malkadi/FGPU/benchmark/HLS/README.md

This folder contains implementations of some selected appplications using Vivado HLS (v2016.2).

+ The folders <application>_HLS_project are the HLS projects 
+ The folder <application>_vivado contains:
  + The device utilization and timing reports when implementing the HLS cores (on ZC706)
  + A script to generate the corresponding SDK projects to measure the execution time/power consumption of each core
