malkadi/FGPU/benchmark/HLS/fir_vivado/fir_vivado.sdk/results.txt

solution1: 7174
solution2: 5637
solution3: 231
