malkadi/FGPU/(threads)

Thread 2 (2022-10-18):

PYNQ-Z2

Bahadiirr, 2022-10-18:
can i do this project on PYNQ Z2 board?

omerguzelelectronicguy, 2022-10-27:
I don't know the versions of ZYNQ devices however it is written like that in [this repo](https://github.com/CEatBTU/FGPU):

> Easily portable to ZYNQ devices. For Ultrascale+ architecture, check branch ultrascale.

That repo stated below that they are continuing the development of this project. If the above quotation doesn't answer enough, you may try to find an answer on that page.

> FGPU is currently being developed and maintained by the [Chair of Computer Engineering at the Brandenburg University of Technology Cottbus-Senftenberg](https://www.b-tu.de/en/computer-engineering-group), in Germany. It was [originally developed](https://github.com/malkadi/FGPU) by Muhammed Al Kadi from the [Ruhr University Bochum](https://www.ei.ruhr-uni-bochum.de/fakultaet/), in Germany.
