malkadi/FGPU/benchmark/LUdecomposition/src/code.c

unsigned int ludecomposition[] = {
	0x11ffd3ff,
	0xdc002fe9,
	0xdc002bea,
	0xdc0027eb,
	0xdc0023ec,
	0xdc001fed,
	0xdc001bee,
	0xdc0017ef,
	0xdc0013f0,
	0xdc000ff1,
	0xdc000bf2,
	0xdc0007f3,
	0x10000403,
	0x34000c41,
	0x1900000c,
	0x1d00004c,
	0x30003021,
	0x29005c64,
	0x3103fc85,
	0x11fffca4,
	0x1103f406,
	0xb60010c9,
	0x11000006,
	0x19fffc64,
	0x1d01fc04,
	0x30001068,
	0x3000104a,
	0x29005c47,
	0x3103fce7,
	0x63001409,
	0x11fffce9,
	0x1103f80b,
	0xb6002d2b,
	0x10001809,
	0x6301b00b,
	0x19fffc6b,
	0x1dfffc2b,
	0x30002c69,
	0x1900040d,
	0x1dfe002d,
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
};
unsigned *code = ludecomposition;
