malkadi/FGPU/benchmark/matrix_multiply/src/code.c

unsigned int matrix_multiply[] = {
	0x11fffbff,
	0xdc0007e9,
	0xdc0003ea,
	0x19fffc63,
	0x1dfffc23,
	0x30000c24,
	0x11fffc85,
	0x19fff866,
	0x1dfdfc26,
	0xb60014c6,
	0x30000c45,
	0x63001406,
	0x11fffca3,
	0x19fffc66,
	0x1dfdfc26,
	0xb6001863,
	0x63006403,
	0x34000443,
	0x19000006,
	0x1d000046,
	0x34001863,
	0x19000008,
	0x1dff0028,
	0x10000407,
	0x48000d07,
	0x19000006,
	0x1dfe0026,
	0x34001889,
	0x10000403,
	0x480024e3,
	0xb60014c7,
	0xb60010c9,
	0x32001d27,
	0x40001d03,
	0x620364c4,
	0x63036007,
	0x10000803,
	0x620358c5,
	0x63000404,
	0x6202dc00,
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
};
unsigned *code = matrix_multiply;
