malkadi/FGPU/benchmark/nbody/src/kernel_descriptor.cpp

#include "kernel_descriptor.hpp"

#define PRINT_ERRORS  1
extern unsigned int *code; // binary storde in code.c as an array

template<typename T>
kernel<T>::kernel(unsigned max_size)
{
  position = new T[4*max_size];
  new_position_arm = new T[4*max_size];
  new_position_fgpu = new T[4*max_size];
  velocity = new T[4*max_size];
  new_velocity_arm = new T[4*max_size];
  new_velocity_fgpu = new T[4*max_size];
  deltaTime = 0.005;
  epsSqr = 500;
}
template<typename T>
kernel<T>::~kernel() 
{
  delete[] position;
  delete[] new_position_arm;
  delete[] new_position_fgpu;
  delete[] velocity;
  delete[] new_velocity_arm;
  delete[] new_velocity_fgpu;
}
template<typename T>
void kernel<T>::download_code()
{
  volatile unsigned *cram_ptr = (unsigned *)(FGPU_BASEADDR+ 0x4000);
  unsigned int size = NBODY_LEN;
  if(typeid(T) == typeid(float))
    start_addr = NBODY_ITER_POS;
  else
    assert(0 && "unsupported type");
  unsigned i = 0;
  for(; i < size; i++){
    cram_ptr[i] = code[i];
  }
}
template<typename T>
void kernel<T>::download_descriptor()
{
  int i;
  volatile unsigned* lram_ptr = (unsigned*)FGPU_BASEADDR;
  for(i = 0; i < 32; i++)
    lram_ptr[i] = 0;
  lram_ptr[0] = ((nWF_WG-1) << 28) | (0 << 14) | (start_addr);
  lram_ptr[1] = size0;
  lram_ptr[2] = size1;
  lram_ptr[3] = size2;
  lram_ptr[4] = offset0;
  lram_ptr[5] = offset1;
  lram_ptr[6] = offset2;
  lram_ptr[7] = ((nDim-1) << 30) | (wg_size2 << 20) | (wg_size1 << 10) | (wg_size0);
  lram_ptr[8] = n_wg0-1;
  lram_ptr[9] = n_wg1-1;
  lram_ptr[10] = n_wg2-1;
  lram_ptr[11] = (nParams << 28) | wg_size;
  lram_ptr[16] = (unsigned) position;
  lram_ptr[17] = (unsigned) velocity;
  lram_ptr[18] = (unsigned) toRep(deltaTime);
  lram_ptr[19] = (unsigned) toRep(epsSqr);
  lram_ptr[20] = (unsigned) new_position_fgpu;
  lram_ptr[21] = (unsigned) new_velocity_fgpu;

}
template<typename T>
void kernel<T>::compute_descriptor()
{
  assert(wg_size0 > 0 && wg_size0 <= 512);
  assert(size0 % wg_size0 == 0);
  size = size0;
  wg_size = wg_size0;
  n_wg0 = size0 / wg_size0;
  if(nDim > 1)
  {
    assert(wg_size1 > 0 && wg_size1 <= 512);
    assert(size1 % wg_size1 == 0);
    size = size0 * size1;
    wg_size = wg_size0 * wg_size1;
    n_wg1 = size1 / wg_size1;
  }
  else
  {
    wg_size1 = n_wg1 = size1 = 0;
  }
  if(nDim > 2)
  {
    assert(wg_size2 > 0 && wg_size2 <= 512);
    assert(size2 % wg_size2 == 0);
    size = size0 * size1 * size2;
    wg_size = wg_size0 * wg_size1 * wg_size2;
    n_wg2 = size2 / wg_size2;
  }
  else
  {
    wg_size2 = n_wg2 = size2 = 0;
  }
  assert(wg_size <= 512);
  nWF_WG = wg_size / 64;
  if(wg_size % 64 != 0)
    nWF_WG++;
}
template<typename T>
void kernel<T>::prepare_descriptor(unsigned int Size)
{
  wg_size0 = 64;
  problemSize = Size;
  offset0 = 0;
  nDim = 1;
  size0 = Size;
  dataSize = sizeof(T) * problemSize;

  if(size0 < 64)
    wg_size0 = size0;

  compute_descriptor();

  offset0 = offset1 = offset2 = 0;
  nParams = 6; // number of parameters
}
template<typename T>
unsigned kernel<T>::get_problemSize() 
{
  return problemSize;
}
template<typename T>
void kernel<T>::initialize_memory()
{
  unsigned i;
  T *pos_ptr = (T*) position;
  T *vel_ptr = (T*) velocity;
  for(i = 0; i < 4*problemSize; i++) 
  {
    pos_ptr[i] = (T)i;
    vel_ptr[i] = (T)i;
  }
  Xil_DCacheFlush(); // flush data to global memory
}
void Nbody_iter(unsigned problemSize, float *initPos, float *newPos, float *initVel, float *newVel, float softeningFactor, float deltaTime) 
{
  unsigned body, i;
  float x1, y1, z1, x2, y2, z2, m2;
  float xdiff, ydiff, zdiff, distSquared;
  float accx, accy, accz;
  float invDist, invDistCube, s;
  float oldVelx, oldVely, oldVelz;
  for( body = 0; body < problemSize; body++) {
    /* printf("initPos[i].x = %f\n", initPos[4*body]); */
    x1 = initPos[body*4];
    y1 = initPos[body*4+1];
    z1 = initPos[body*4+2];
    accx = 0;
    accy = 0;
    accz = 0;
    for (i = 0; i < problemSize; i++) {
      x2 = initPos[i*4];
      y2 = initPos[i*4+1];
      z2 = initPos[i*4+2];
      m2 = initPos[i*4+3];
      xdiff = x2 - x1;
      ydiff = y2 - y1;
      zdiff = z2 - z1;
      distSquared = xdiff*xdiff + ydiff*ydiff + zdiff*zdiff;

      invDist = 1.0f / sqrtf(distSquared + softeningFactor);
      invDistCube = invDist * invDist * invDist;
      s = m2 * invDistCube;
      // accumulate effect of all particles
      accx += s * xdiff;
      /* printf("s = %f\n", s); */
      accy += s * ydiff;
      accz += s * zdiff;
    }

    oldVelx = initVel[body*4];
    oldVely = initVel[body*4+1];
    oldVelz = initVel[body*4+2];
    // updated position and velocity
    newPos[body*4] = x1 + oldVelx*deltaTime + accx*0.5f*deltaTime*deltaTime;
    newPos[body*4+1] = y1 + oldVely*deltaTime + accy*0.5f*deltaTime*deltaTime;
    newPos[body*4+2] = z1 + oldVelz*deltaTime + accz*0.5f*deltaTime*deltaTime;

    newVel[body*4] = oldVelx + accx*deltaTime;
    newVel[body*4+1] = oldVely + accy*deltaTime;
    newVel[body*4+2] = oldVelz + accz*deltaTime;
  }
}
template<typename T>
unsigned kernel<T>::compute_on_ARM(unsigned int n_runs)
{
  unsigned exec_time = 0;
  unsigned runs = 0;

  XTime tStart, tEnd;
  while(runs < n_runs)
  {
    initialize_memory();
    Xil_DCacheFlush();
    Xil_DCacheInvalidate();
    XTime_GetTime(&tStart);
    
    Nbody_iter(problemSize, position, new_position_arm, velocity, new_velocity_arm, epsSqr, deltaTime);

    // flush the results to the global memory 
    Xil_DCacheFlushRange((unsigned)new_position_arm, dataSize);
    Xil_DCacheFlushRange((unsigned)new_velocity_arm, dataSize);
    
    XTime_GetTime(&tEnd);
    exec_time += elapsed_time_us(tStart, tEnd);
    xil_printf(ANSI_COLOR_RED "." ANSI_COLOR_RESET);
    fflush(stdout);
    runs++;
    if(exec_time > 1000000*MAX_MES_TIME_S)
      break;
  }
  return exec_time/runs;
}
// void kernel<T>::check_FGPU_results()
// {
//   unsigned int i, nErrors = 0;
//   for (i = 0; i < problemSize; i++) {
//     for(unsigned k = 0; k < 3; k++) {
//       // float upper = new_position_arm[4*i+k]*1.001;
//       // float lower = new_position_arm[4*i+k]*0.999;
//       if(new_position_arm[4*i+k] != new_position_fgpu[4*i+k] ) {
//       // if(new_position_fgpu[4*i+k] < lower || new_position_fgpu[4*i+k] > upper) {
//         if(PRINT_ERRORS && nErrors < 10)
//           printf("newPosition[%d]=%f (must be %f)\n\r", 4*i+k, (float)new_position_fgpu[4*i+k], (float) new_position_arm[4*i+k]);
//         nErrors++;
//       }
//       // upper = new_velocity_arm[4*i+k]*1.01;
//       // lower = new_velocity_arm[4*i+k]*0.99;
//       if(new_velocity_arm[4*i+k] != new_velocity_fgpu[4*i+k] ) {
//       // if(new_velocity_fgpu[4*i+k] < lower || new_velocity_fgpu[4*i+k] > upper) {
//         if(PRINT_ERRORS && nErrors < 10)
//           printf("newVelocity[%d]=%f (must be %f)\n\r", 4*i+k, (float)new_velocity_fgpu[4*i+k], (float) new_velocity_arm[4*i+k]);
//           // printf("newVelocity[%d]=%x (must be %x)\n\r", 4*i+k, (unsigned)toRep(new_velocity_fgpu[4*i+k]), (unsigned) toRep(new_velocity_arm[4*i+k]));
//         nErrors++;
//       }
//     }
//   }
//   if(nErrors != 0)
//     xil_printf("Memory check failed (nErrors = %d)!\n\r", nErrors);
// }
template<typename T>
void kernel<T>::check_FGPU_results()
{
  unsigned int i, nErrors = 0;
  for (i = 0; i < problemSize; i++) {
    for(unsigned k = 0; k < 3; k++) {
      if(new_position_arm[4*i+k] != new_position_fgpu[4*i+k])
      {
        if(PRINT_ERRORS && nErrors < 10)
          printf("newPosition[%d]=%f (must be %f)\n\r", 4*i+k, (float)new_position_fgpu[4*i+k], (float) new_position_arm[4*i+k]);
        nErrors++;
      }
      if(new_velocity_arm[4*i+k] != new_velocity_fgpu[4*i+k])
      {
        if(PRINT_ERRORS && nErrors < 10)
          printf("newVelocity[%d]=%f (must be %f)\n\r", 4*i+k, (float)new_velocity_fgpu[4*i+k], (float) new_velocity_arm[4*i+k]);
        nErrors++;
      }
    }
  }
  if(nErrors != 0)
    xil_printf("Memory check failed (nErrors = %d)!\n\r", nErrors);
}
template<typename T>
unsigned kernel<T>::compute_on_FGPU(unsigned n_runs, bool check_results)
{
  unsigned runs = 0;
  XTime tStart, tEnd;
  unsigned exec_time = 0;

  while(runs < n_runs)
  {
    download_descriptor();
    REG_WRITE(INITIATE_REG_ADDR, 0xFFFF); // initiate FGPU when execution starts
    REG_WRITE(CLEAN_CACHE_REG_ADDR, 0xFFFF); // clean FGPU cache at end of execution
    
    XTime_GetTime(&tStart);
    REG_WRITE(START_REG_ADDR, 1);
    while(REG_READ(STATUS_REG_ADDR)==0);
    XTime_GetTime(&tEnd);
    exec_time += elapsed_time_us(tStart, tEnd);
    
    if(check_results)
      check_FGPU_results();

    xil_printf(ANSI_COLOR_GREEN "." ANSI_COLOR_RESET);
    fflush(stdout);
    runs++;

    if(exec_time > 1000000*MAX_MES_TIME_S)// do not execute all required runs if it took too long
      break;
  }
  return exec_time/runs;
}
template<typename T>
void kernel<T>::print_name()
{
  if( typeid(T) == typeid(float) )
    xil_printf("\n\r" ANSI_COLOR_YELLOW "Kernel is nbody float\n\r" ANSI_COLOR_RESET);
}

template class kernel<float>;
