malkadi/FGPU/benchmark/div/src/code.c

unsigned int div[] = {
	0x29007c23,
	0xb6000864,
	0x10000805,
	0x40001005,
	0x12001463,
	0x19000005,
	0x1d000045,
	0x40001005,
	0x21000463,
	0x29007824,
	0x31000484,
	0x32001063,
	0x19000004,
	0x1d000024,
	0xb6000866,
	0x40001804,
	0x32001484,
	0x10000805,
	0x40001805,
	0x12001463,
	0x29007425,
	0x310004a5,
	0x21000463,
	0x32001463,
	0x19000005,
	0x1d800005,
	0xb6000866,
	0x40001805,
	0x32001484,
	0x10000805,
	0x40001805,
	0x12001463,
	0x29007025,
	0x310004a5,
	0x21000463,
	0x32001463,
	0x19000005,
	0x1d400005,
	0xb6000866,
	0x40001805,
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
};
unsigned *code = div;
