malkadi/FGPU/benchmark/parallel_selection/src/code.c

unsigned int parallel_selection[] = {
	0xb2000444,
	0x11000405,
	0x11fffc06,
	0x10001403,
	0x400010c3,
	0xb2000824,
	0x10001407,
	0x400010c7,
	0x30000444,
	0xb20010c4,
	0x400010e3,
	0x32000444,
	0x19fffc66,
	0x1dfffc26,
	0x30001884,
	0x48001003,
	0x34000824,
	0x48001003,
	0x30001842,
	0x19000004,
	0x1dfe0024,
	0xb6000882,
	0x400008a3,
	0x30001821,
	0xb6000481,
	0x400004a3,
	0x10000c01,
	0x92000000,
	0xb2000444,
	0x11000405,
	0x11fffc06,
	0x10001403,
	0x400010c3,
	0xb2000824,
	0x10001407,
	0x400010c7,
	0x30000444,
	0xb20010c4,
	0x400010e3,
	0x32000444,
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
};
unsigned *code = parallel_selection;
