malkadi/FGPU/benchmark/max/src/code.c

unsigned int max[] = {
	0x32000443,
	0x19fffc64,
	0x1dfffc24,
	0x30001063,
	0x34000821,
	0xb7000421,
	0x11000402,
	0x48000c41,
	0x92000000,
	0x32000443,
	0x19fffc64,
	0x1dfffc24,
	0x30001063,
	0x34000821,
	0xb6000401,
	0x48000c01,
	0x92000000,
	0x30000443,
	0x11fffc04,
	0xb2000c84,
	0xb2000443,
	0xb2000825,
	0x400010a3,
	0x32000444,
	0x19fffc65,
	0x1dfffc25,
	0x30001484,
	0x11000405,
	0x480010a3,
	0x34000821,
	0x480004a3,
	0x10000c01,
	0x92000000,
	0x30000443,
	0x11fffc04,
	0xb2000c84,
	0xb2000443,
	0xb2000825,
	0x400010a3,
	0x32000444,
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
};
unsigned *code = max;
