malkadi/FGPU/benchmark/floydwarshall/src/code_hard_float.c

unsigned int floydwarshall_hard_float[] = {
	0xa8000002,
	0xa8000023,
	0xa0000004,
	0xa1000005,
	0x100010a4,
	0xa0000025,
	0xa1000026,
	0x100014c5,
	0xa2000006,
	0x10001001,
	0x580018a1,
	0x10000c07,
	0x580018a7,
	0x58000cc4,
	0x74000883,
	0x740008e4,
	0xc0000c83,
	0x74000824,
	0xc7001064,
	0x35000484,
	0x63000c04,
	0x21000821,
	0x10000441,
	0x7c000403,
	0x92000000
};
unsigned *code_hard_float = floydwarshall_hard_float;
