malkadi/FGPU/benchmark/sum_power/src/code_hard_float.c

unsigned int sum_power_hard_float[] = {
	0xa8000043,
	0xa8000022,
	0xa8000064,
	0xa8000006,
	0xa0000005,
	0xa1000007,
	0x100014e5,
	0x210008a1,
	0x100004c7,
	0x19000006,
	0x1d000006,
	0xa2000008,
	0x21000901,
	0x100004e8,
	0x74001c07,
	0xc80010e7,
	0xc1001ce7,
	0xc0001cc6,
	0x11fffc63,
	0x10002007,
	0x63ffe003,
	0x7c0008a6,
	0x92000000,
	0xa8000043,
	0xa8000022,
	0xa8000005,
	0xa0000004,
	0xa1000006,
	0x100010c4,
	0x21000881,
	0x100004a6,
	0x19000005,
	0x1d000005,
	0xa2000007,
	0x210008e1,
	0x100004c7,
	0x74001806,
	0xc00018a5,
	0x11fffc63,
	0x10001c06,
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
};
unsigned *code_hard_float = sum_power_hard_float;
