malkadi/FGPU/benchmark/LUdecomposition/src/code_hard_float.c

unsigned int ludecomposition_hard_float[] = {
	0xa8000043,
	0xa0000022,
	0xa1000024,
	0x10000882,
	0xa0000006,
	0xa1000008,
	0xb6000c41,
	0x62007c01,
	0xa8000001,
	0xa8000064,
	0x10001005,
	0x58000ca5,
	0x740004a7,
	0x10001009,
	0x58000c49,
	0x7400052a,
	0xc2001d47,
	0x10001906,
	0x63002086,
	0xa8000021,
	0x7c000527,
	0x11000483,
	0x63004062,
	0x19000002,
	0x1dfe0002,
	0x7c0004a2,
	0x62003000,
	0xb6000cc5,
	0x62002805,
	0x10001805,
	0x58000c85,
	0x740004a4,
	0xc10010e4,
	0x58000c46,
	0x740004c2,
	0xc8001042,
	0x210008c3,
	0x10000c21,
	0x7c000402,
	0x92000000
};
unsigned *code_hard_float = ludecomposition_hard_float;
