malkadi/FGPU/benchmark/edge_detection/src/aux_functions.hpp

/*
 * aux_functions.h
 *
 *  Created on: 30.06.2015
 *      Author: muhammed
 */
#ifndef AUX_FUNCTIONS_H_
#define AUX_FUNCTIONS_H_

#define FGPU_BASEADDR         0x43C00000
// This address is used synchronize the power measurement that runs on s on the second arm core
#define POWER_SYNC_ADDR       0x3FFFFF20  
#define POWER_RESULTS         0x3Efff000

#include <iostream>
#include <iomanip>
#include <stdio.h>
#include <stdlib.h>
#include <math.h>
#include <complex.h>
#include <assert.h>
#include <sys/reent.h>
#include <xil_cache.h>
#include <xil_types.h>
#include <xtime_l.h>
#include "xparameters.h"
#include "xscugic.h"
#include "xil_exception.h"
#include "assert.h"
#include "code.h"
#include "kernel_descriptor.hpp"

#define MAX_DIM                 1024   // The execution will break if bigger problem sizes are executed
#define MAX_MES_TIME_S          2     // maximum execution time of a kernel at any size.
                                      // The execution will not repeat if this number is exceeded
class power_measure {
  enum state {uninitialized, idle, running, finished};
  state cur_state;
  volatile unsigned *msync;
  volatile float *res;
public:
  power_measure():msync((unsigned *)POWER_SYNC_ADDR), res((volatile float *)POWER_RESULTS){}
  void set_idle();
  void start();
  void stop();
  void print_values();
  void wait_power_values();
};

// Control Registers of FGPU
#define STATUS_REG_ADDR         (FGPU_BASEADDR+ 0x8000)
#define START_REG_ADDR          (FGPU_BASEADDR+ 0x8004)
#define CLEAN_CACHE_REG_ADDR    (FGPU_BASEADDR+ 0x8008)
#define INITIATE_REG_ADDR       (FGPU_BASEADDR+ 0x800C)

#define MAX(a, b)    ((a)>(b)?(a):(b))




// Macros
#define REG_READ(addr) \
    ({int val;int a=addr; asm volatile ("ldr   %0,[%1]\n" : "=r"(val) : "r"(a)); val;})

#define REG_WRITE(addr,val) \
    ({int v = val; int a = addr; __asm volatile ("str  %1,[%0]\n" :: "r"(a),"r"(v)); v;})



void wait_ms(u64 time);
u64 elapsed_time_us(XTime tStart, XTime tEnd);



#define ANSI_COLOR_RED     "\x1b[31m"
#define ANSI_COLOR_GREEN   "\x1b[32m"
#define ANSI_COLOR_YELLOW  "\x1b[33m"
#define ANSI_COLOR_BLUE    "\x1b[34m"
#define ANSI_COLOR_MAGENTA "\x1b[35m"
#define ANSI_COLOR_CYAN    "\x1b[36m"
#define ANSI_COLOR_RESET   "\x1b[0m"

#endif /* AUX_FUNCTIONS_H_ */
