malkadi/FGPU/benchmark/fir/src/code_hard_float.c

unsigned int fir_hard_float[] = {
	0xa8000063,
	0xa8000042,
	0xa8000024,
	0xa8000005,
	0xa0000006,
	0xa1000007,
	0x100018e1,
	0x21000826,
	0x100018a6,
	0x19000005,
	0x1d000005,
	0x74001007,
	0x74001808,
	0xc1001d07,
	0xc0001ca5,
	0x110010c6,
	0x11001084,
	0x11fffc63,
	0x63ffe003,
	0x7c000825,
	0x92000000
};
unsigned *code_hard_float = fir_hard_float;
