malkadi/FGPU/benchmark/matrix_multiply/src/code_hard_float.c

unsigned int matrix_multiply_hard_float[] = {
	0xa8000042,
	0xa8000005,
	0xa8000024,
	0xa0000023,
	0xa1000026,
	0x10000cc6,
	0xa0000003,
	0xa1000007,
	0x10000ce3,
	0x21000861,
	0x10000487,
	0xa2000004,
	0x51001881,
	0x21000826,
	0x100018a6,
	0x19000005,
	0x1d000005,
	0x21000888,
	0x100020e9,
	0x74001c07,
	0x7400180a,
	0xc1001d47,
	0xc0001ca5,
	0x110010c6,
	0x11fffc84,
	0x10002407,
	0x63ffdc04,
	0x10000c21,
	0x7c000825,
	0x92000000
};
unsigned *code_hard_float = matrix_multiply_hard_float;
