malkadi/FGPU/benchmark/xcorr/src/code_hard_float.c

unsigned int xcorr_hard_float[] = {
	0xa8000042,
	0xa8000003,
	0xa8000025,
	0xa0000004,
	0xa1000006,
	0x100010c4,
	0x21000881,
	0x100004a6,
	0x19000005,
	0x1d000005,
	0xa2000007,
	0x74001801,
	0x74000c08,
	0xc1000501,
	0xc00004a5,
	0x11001063,
	0x110010c6,
	0x11fffce7,
	0x63ffe007,
	0x7c000885,
	0x92000000
};
unsigned *code_hard_float = xcorr_hard_float;
