malkadi/FGPU/benchmark/div/src/code_hard_float.c

unsigned int div_hard_float[] = {
	0xa8000022,
	0xa8000043,
	0xa8000004,
	0xa0000005,
	0xa1000006,
	0x100014c1,
	0x74001024,
	0xc2000c83,
	0x7c000823,
	0x92000000
};
unsigned *code_hard_float = div_hard_float;
