malkadi/FGPU/benchmark/bitonic/src/code_hard_float.c

unsigned int bitonic_hard_float[] = {
	0xa8000002,
	0xa8000043,
	0xa8000064,
	0xa8000025,
	0xa0000006,
	0xa1000007,
	0x100018e1,
	0x31007ca6,
	0x11000407,
	0x200018e6,
	0x30001826,
	0x120010e8,
	0x48001888,
	0x12000ca3,
	0x31007c63,
	0x20000ce4,
	0x11fffc85,
	0x30001425,
	0x28000c21,
	0x51000481,
	0x21000421,
	0x10001421,
	0x74000823,
	0x10001024,
	0x74000885,
	0xc7000ca6,
	0x10001407,
	0x40001867,
	0x400018a3,
	0x10001c05,
	0x40002065,
	0x7c000825,
	0x400020e3,
	0x7c000883,
	0x92000000
};
unsigned *code_hard_float = bitonic_hard_float;
