malkadi/FGPU/benchmark/max/src/code_hard_float.c

unsigned int max_hard_float[] = {
	0xa8000022,
	0xa8000005,
	0xa8000044,
	0xa0000003,
	0xa1000006,
	0x10000cc3,
	0x11fffc84,
	0xa2000007,
	0x10001c61,
	0x21000821,
	0x100004a1,
	0x74001466,
	0x210008e5,
	0x74000407,
	0xc70018e8,
	0x400020c7,
	0x10001421,
	0x11fffc84,
	0x10001c06,
	0x63ffe404,
	0x7c000867,
	0x92000000
};
unsigned *code_hard_float = max_hard_float;
