malkadi/FGPU/benchmark/parallel_selection/src/code_hard_float.c

unsigned int parallel_selection_hard_float[] = {
	0xa8000022,
	0xa8000003,
	0xa0000004,
	0xa1000005,
	0x100010a4,
	0x11000005,
	0xa2000006,
	0x74000c81,
	0x10001407,
	0x74000c08,
	0xc7002029,
	0xc7000508,
	0x38002509,
	0xb20010aa,
	0x30002549,
	0x32002508,
	0x10001d07,
	0x11001063,
	0x110004a5,
	0x63ffd4a6,
	0x7c0008e1,
	0x92000000
};
unsigned *code_hard_float = parallel_selection_hard_float;
