malkadi/FGPU/benchmark/matrix_multiply/src/code.h

#define MATRIX_MULTIPLY_LEN                 750
#define MATRIX_MULTIPLY_POS                 511
#define MATRIX_MULTIPLY_HALF_POS            538
#define MATRIX_MULTIPLY_HALF_IMPROVED_POS   573
#define MATRIX_MULTIPLY_BYTE_POS            621
#define MATRIX_MULTIPLY_BYTE_IMPROVED_POS   654
#define MATRIX_MULTIPLY_FLOAT_POS           719
