malkadi/FGPU/benchmark/parallel_selection/src/code.h

#define PARALLEL_SELECTION_LEN              392
#define PARALLELSELECTION_POS               176
#define PARALLELSELECTION_HALF_POS          198
#define PARALLELSELECTION_HALF_IMPROVED_POS 234
#define PARALLELSELECTION_BYTE_IMPROVED_POS 277
#define PARALLELSELECTION_BYTE_POS          333
#define PARALLELSELECTION_FLOAT_POS         364
