malkadi/FGPU/benchmark/xcorr/src/code.h

#define XCORR_LEN                           750
#define XCORR_POS                           511
#define XCORR_IMPROVED_POS                  530
#define XCORR_HALF_POS                      570
#define XCORR_HALF_IMPROVED_POS             597
#define XCORR_BYTE_POS                      634
#define XCORR_BYTE_IMPROVED_POS             660
#define XCORR_FLOAT_POS                     727
