malkadi/FGPU/benchmark/edge_detection/src/code.c

unsigned int edge_detection[] = {
	0xa0000023,
	0xa1000024,
	0xa0000002,
	0xa1000005,
	0x100008a2,
	0x10000c84,
	0x34000081,
	0xb7000421,
	0x34000043,
	0xb7000463,
	0x32000463,
	0xa2000005,
	0x11fff8a1,
	0xb6001026,
	0x32001863,
	0xb6000821,
	0x32000461,
	0x63016401,
	0xa8000041,
	0xa8000023,
	0xa8000006,
	0x11fffc87,
	0x10000808,
	0x58001ca8,
	0x11000487,
	0x10000809,
	0x58001ca9,
	0x580010a2,
	0x21000844,
	0x10001884,
	0x21000925,
	0x100014c5,
	0x74001907,
	0x21000908,
	0x100020c8,
	0x74001926,
	0x11fff009,
	0x1100100a,
	0x7100214b,
	0x71002128,
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
};
unsigned *code = edge_detection;
