malkadi/FGPU/benchmark/nbody/src/code.c

unsigned int nbody[] = {
	0xa80000a3,
	0xa8000086,
	0xa8000029,
	0xa8000042,
	0xa800006b,
	0xa800000c,
	0xa0000004,
	0xa1000005,
	0x100010a1,
	0x1100000d,
	0x21001025,
	0x10001588,
	0x19000004,
	0x1d000004,
	0xa200000e,
	0x74002007,
	0x11002101,
	0x7400040a,
	0x11001101,
	0x7400040f,
	0x19000010,
	0x1dfe0010,
	0x10001008,
	0x10001001,
	0x11001191,
	0x74004411,
	0xc8003e31,
	0x74003012,
	0xc8001e52,
	0xc1004a53,
	0xc1004634,
	0xc0005273,
	0x11002194,
	0x74005014,
	0xc8002a94,
	0xc1005295,
	0xc0004eb3,
	0xc0002e73,
	0xc4004e73,
	0xc2004e13,
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
};
unsigned *code = nbody;
