malkadi/FGPU/benchmark/vec_add/src/code_hard_float.c

unsigned int vec_add_hard_float[] = {
	0xa8000042,
	0xa8000003,
	0xa8000024,
	0xa0000005,
	0xa1000006,
	0x100014c1,
	0x74001024,
	0x74000c23,
	0xc0001063,
	0x7c000823,
	0x92000000
};
unsigned *code_hard_float = vec_add_hard_float;
