malkadi/FGPU/benchmark/fir/src/code.h

#define FIR_LEN                             719
#define FIR_FLOAT_POS                       511
#define FIR_POS                             534
#define FIR_HALF_POS                        553
#define FIR_HALF_IMPROVED_POS               580
#define FIR_BYTE_POS                        622
#define FIR_BYTE_IMPROVED_POS               648
