malkadi/FGPU/benchmark/max/src/code.h

#define MAX_LEN                             455
#define MAX_FLOAT_POS                       83
#define MAX_WORD_POS                        108
#define MAX_HALF_POS                        130
#define MAX_HALF_IMPROVED_POS               162
#define MAX_BYTE_POS                        198
#define MAX_BYTE_IMPROVED_POS               228
#define MAX_BYTE_IMPROVED_ATOMIC_POS        280
#define MAX_ATOMIC_POS                      332
#define MAX_HALF_ATOMIC_POS                 355
#define MAX_HALF_IMPROVED_ATOMIC_POS        388
#define MAX_BYTE_ATOMIC_POS                 424
