malkadi/FGPU/benchmark/sum/src/code.h

#define SUM_LEN                             519
#define SUM_ATOMIC_WORD_POS                 0
#define SUM_HALF_ATOMIC_POS                 19
#define SUM_HALF_IMPROVED_ATOMIC_POS        42
#define SUM_BYTE_ATOMIC_POS                 68
#define SUM_BYTE_IMPROVED_ATOMIC_POS        89
#define SUM_POS                             121
#define SUM_HALF_POS                        140
#define SUM_HALF_IMPROVED_POS               163
#define SUM_BYTE_POS                        189
#define SUM_BYTE_IMPROVED_POS               210
#define SUM_FLOAT_POS                       499
