malkadi/FGPU/benchmark/sum_power/src/code.h

#define SUM_POWER_LEN                       875
#define SUM_POWER_FLOAT_POS                 769
#define SUM_FLOAT_POS                       795
#define SUM_POWER_POS                       815
#define SUM_POWER_ATOMIC_POS                836
#define SUM_POS                             856
