malkadi/FGPU/benchmark/vec_add/src/code.h

#define VEC_ADD_LEN                         374
#define VEC_ADD_POS                         0
#define VEC_ADD_HALF_POS                    11
#define VEC_ADD_HALF_IMPROVED_POS           33
#define VEC_ADD_BYTE_POS                    54
#define VEC_ADD_BYTE_IMPROVED_POS           75
#define ADD_FLOAT_POS                       363
