malkadi/FGPU/benchmark/vec_mul/src/code.h

#define VEC_MUL_LEN                         371
#define VEC_MUL_POS                         0
#define VEC_MUL_HALF_POS                    11
#define VEC_MUL_HALF_IMPROVED_POS           33
#define VEC_MUL_BYTE_POS                    54
#define VEC_MUL_BYTE_IMPROVED_POS           75
#define MUL_FLOAT_POS                       360
