malkadi/FGPU/(commit log)

2016-11-11 bug fixed, began with matrix multiply
    [aux_functions.cpp, aux_functions.hpp, code.c, code.h, kernel_descriptor.cpp, kernel_descriptor.hpp, main.cpp]
2016-12-09 power measurement added
2016-12-19 power modified
2016-12-20 power measurement suport for MicroBalze is ready
2016-12-22 sobel filter (float) is added to edge detection
2016-12-25 power measurement for soft floating point added
2017-01-10 hard floating-point support with power measurement
