malkadi/FGPU/(notices)

Notices in the files:
benchmark/power_measurement/src/pmbus_iic.c:
� Copyright 2012 - 2013 Xilinx, Inc. All rights reserved.
